Marti402/Hospitalaria-Proyecto/Diseño del Producto/IMG20260511081246.jpg

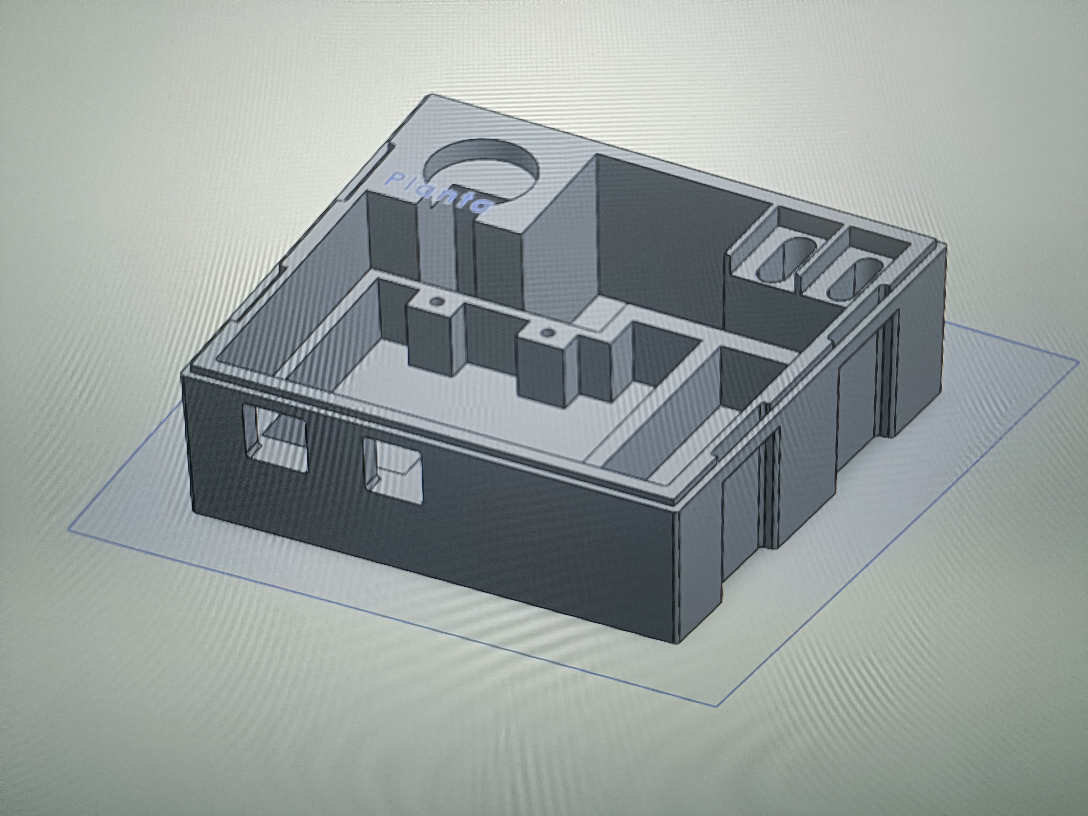
Diseño del Producto/IMG20260511081246.jpg
