Marti402/Hospitalaria-Proyecto/README.md

# Hospitalaria-Proyecto
Proyecto final de Ingeniería Hospitalaria
