Marti402/Hospitalaria-Proyecto/Diseño del Producto/Tapa.SLDPRT

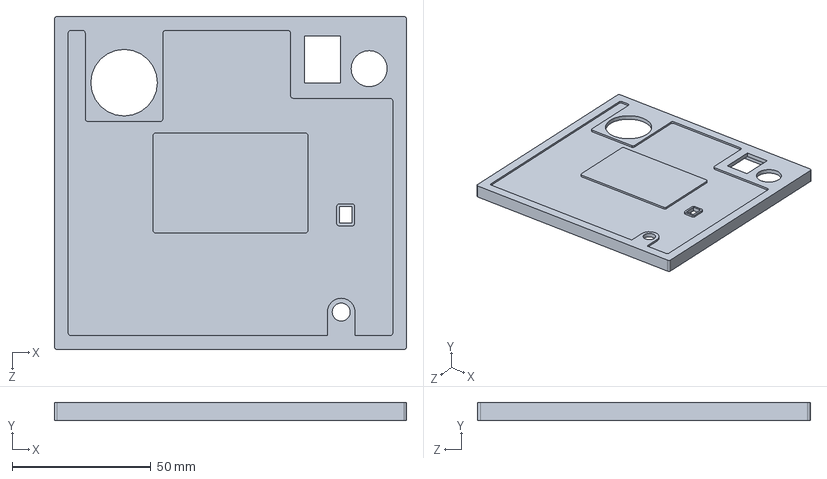
[picture p29: CAD file, 2026-06-12]
Diseño del Producto/Tapa.SLDPRT
127.0 x 6.60 x 120.0 mm
