Marti402/Hospitalaria-Proyecto/Diseño del Producto/Base.SLDPRT

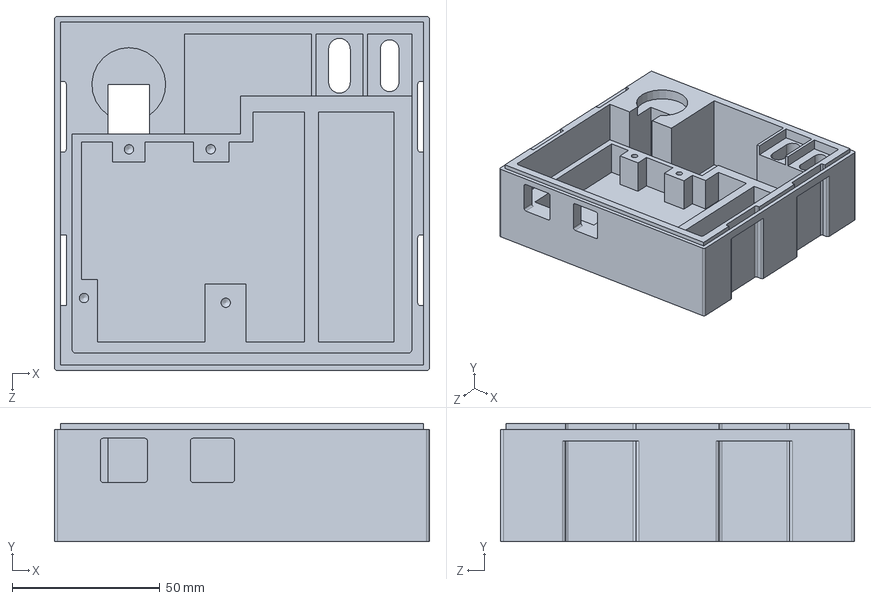
[picture p30: CAD file, 2026-06-12]
Diseño del Producto/Base.SLDPRT
127.0 x 40.0 x 120.0 mm
