Marti402/Hospitalaria-Proyecto/Diseño del Producto/Clips.SLDPRT

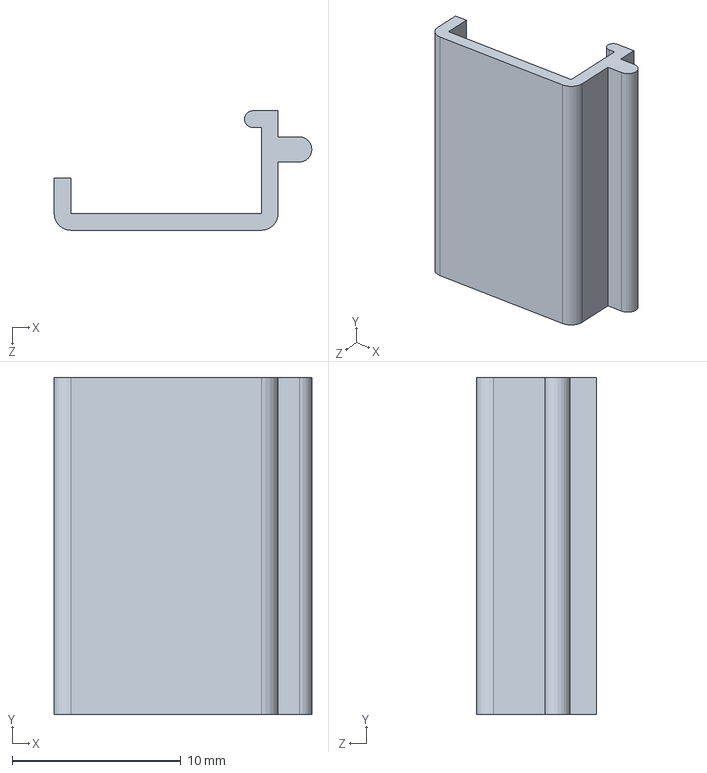
[picture p31: CAD file, 2026-06-12]
Diseño del Producto/Clips.SLDPRT
15.3 x 20.0 x 7.10 mm
