Marti402/Hospitalaria-Proyecto/Diseño del Producto/Alargador del interruptor.SLDPRT

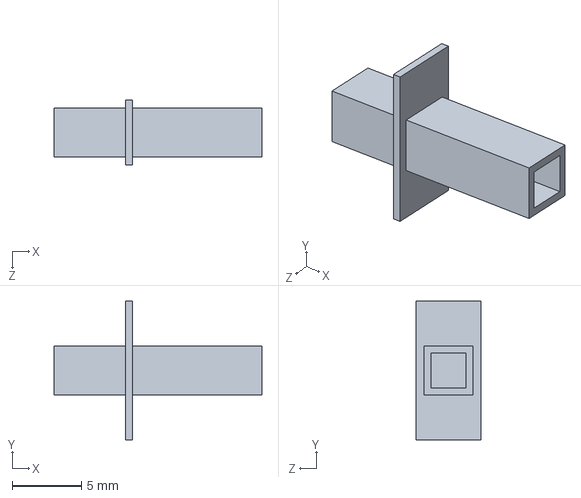
[picture p32: CAD file, 2026-06-12]
Diseño del Producto/Alargador del interruptor.SLDPRT
15.0 x 10.0 x 4.70 mm
