Marti402/Hospitalaria-Proyecto/Diseño del Producto/Ensamblaje Producto final.SLDASM

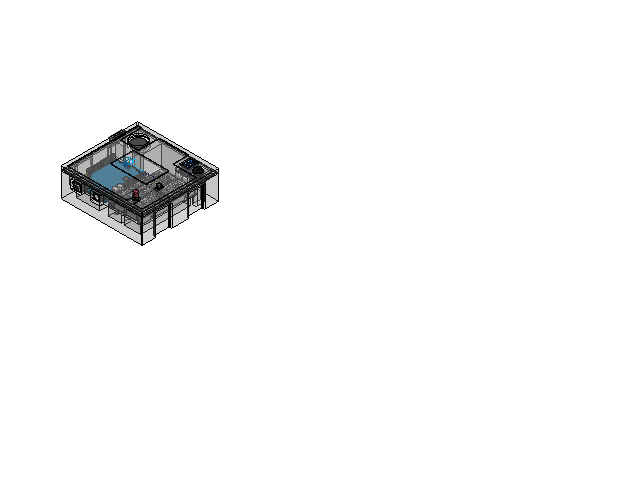
[picture p33: CAD file, 2026-06-12]
Diseño del Producto/Ensamblaje Producto final.SLDASM
Base
Arduino_Board
Breadboard_400pin
Buzzer
TyH sensor
LED rojo
Barcode Scanner
Interruptor
Alargador del interruptor
Tapa
Clips
